Zqaq66/mspm0-temperature-recycling-robot/README.md

# MSPM0 移动测温回收机器人

基于 TI MSPM0G3507 的四轮移动机器人固件与载板设计资料。项目面向移动测温、房间巡检和物品回收任务，包含循迹导航、航向闭环、红外测温、语音提示、无线回传、LCD 显示及 PCB 载板设计。

## 主要功能

- 使用 AuroraT8 灰度传感器完成循迹、路口和支路识别。
- 基于路线表的任务状态机，支持房间停靠、回程、充电区和停车场流程。
- 使用 MLX90614 完成非接触体温测量，采用 PB17/PB18 软件 I2C。
- 使用 UART IMU 完成原地转向和航向闭环。
- 使用 ESP32-S2 授时模块获取日期和时间。
- 使用 ASRPRO2.0 播放房间与任务语音提示。
- 使用 LoRa 回传测量结果和设备状态。
- 使用 ST7735S LCD 显示任务状态、温度、电量及调试信息。
- 提供 MSPM0G3507 载板的 KiCad 原理图、立创 EDA 工程、BOM、网表和接线文档。

## 硬件组成

| 模块 | 用途 |
| --- | --- |
| 天猛星 MSPM0G3507 开发板 | 主控，LQFP-64，80 MHz |
| TB6612 x2 | 四路直流电机驱动 |
| AuroraT8 | I2C 灰度循迹 |
| MLX90614 | 红外测温 |
| UART IMU | 转向与航向反馈 |
| ESP32-S2 授时模块 | 日期和时间同步 |
| ASRPRO2.0 | 语音播报 |
| LoRa 模块 | 远程数据回传 |
| ST7735S LCD | 状态显示 |
| 12 V 电池组 | 电机与载板供电 |

详细引脚定义、电源树和上电检查流程见 [docs/PCB-接线汇总与注意事项.md](docs/PCB-接线汇总与注意事项.md) 与 [pcb/design_guide.md](pcb/design_guide.md)。上电前必须核对实物模块排针定义，尤其注意载板 3.3 V 与天猛星板载 3V3 不得直接并联。

## 目录结构

| 目录 | 内容 |
| --- | --- |
| `app/` | 电机、测温、语音和 IMU 驱动 |
| `middle/` | 任务状态机、循迹、通信、授时和调度 |
| `hardware/` | LCD 驱动与字库 |
| `grayscale/` | AuroraT8 灰度传感器驱动 |
| `BSP/` | 时间与板级支持 |
| `keil/` | Keil MDK 工程、启动文件和链接脚本 |
| `pcb/` | 载板 KiCad/立创 EDA 工程、BOM、网表和预览 |
| `docs/` | 接线与硬件注意事项 |
| `tools/` | PCB、原理图和框图生成脚本 |

## 构建

1. 安装 TI MSPM0 SDK 2.02.00.05 和 Keil MDK，并安装 MSPM0G350x 器件支持包。
2. 使用 Keil 打开 `keil/empty_LP_MSPM0G3507_nortos_keil.uvprojx`。
3. 选择与实物一致的下载器和调试配置，编译并下载固件。
4. 修改外设配置时使用 `empty.syscfg`，并确保生成的 `ti_msp_dl_config.c/.h` 与工程同步。

仓库不包含 Keil 编译产物和用户界面状态文件。`.gitattributes` 保留现有源码的编码与换行方式，避免无意义的整文件差异。

## 调试说明

- LoRa UART3 作为主要运行日志输出口。
- `middle/Mission.c` 中的 `route[]` 表定义任务路线和动作顺序。
- 循迹、转向、测温与语音模块均保留现场调试参数，调整前应先确认对应引脚和电源连接。
- 载板设计文件位于 `pcb/`；重新生成前请阅读生成脚本和验证报告。

## 状态

仓库持续记录机器人固件、任务流程和载板设计的开发进展。硬件行为仍需在实车、真实电源和对应模块上验证，不能仅以编译通过作为系统功能完成的依据。
