Zqaq66/mspm0-temperature-recycling-robot/pcb/netlist.txt

# DZZH carrier board logical netlist
# TMX.<pin> = 天猛星逻辑引脚; Jn.<pin> = 载板连接器

NET +3V3
  U1.OUT+
  C3.1
  C4.1
  R3.1
  R4.1
  R5.1
  R6.1
  R7.1
  R8.1
  J3.VCC
  J4.VCC
  J5.VCC
  J6.VCC
  J7.VCC
  J8.VCC
  J9.VCC
  J10.VIN
  J11.VCC
  J13.VCC
  J15.VCC
  J16.3V3
  J17.3V3

NET +3V3_T
  U3.OUT
  J14.3V3

NET +5V
  D2.A
  U2.OUT+
  U3.IN
  C5.1
  J12.5V

NET ENC_A_A
  J5.A
  TMX.PA21

NET ENC_A_B
  J5.B
  TMX.PA26

NET ENC_B_A
  J6.A
  TMX.PA31

NET ENC_B_B
  J6.B
  TMX.PA28

NET ENC_C_A
  J7.A
  TMX.PA24

NET ENC_C_B
  J7.B
  TMX.PA25

NET ENC_D_A
  J8.A
  TMX.PA14

NET ENC_D_B
  J8.B
  TMX.PA15

NET GND
  J1.2
  D1.G
  TVS1.2
  U1.IN-
  U1.OUT-
  U2.IN-
  U2.OUT-
  U3.GND
  C1.2
  C2.2
  C3.2
  C4.2
  C5.2
  C6.2
  R2.2
  LED1.K
  J3.GND
  J4.GND
  J5.GND
  J6.GND
  J7.GND
  J8.GND
  J9.GND
  J10.GND
  J11.GND
  J12.GND
  J13.GND
  J14.GND
  J15.GND
  SW1.2
  K1.2
  K2.2
  K3.2
  J16.GND
  J17.GND
  TMX.GND

NET I2C0_SCL
  R4.2
  J9.SCL
  TMX.PA1

NET I2C0_SDA
  R3.2
  J9.SDA
  TMX.PA0

NET I2C1_SCL
  R6.2
  J14.SCL
  TMX.PA29

NET I2C1_SDA
  R5.2
  J14.SDA
  TMX.PA30

NET IMU_RX
  J11.TX
  TMX.PA9

NET IMU_TX
  J11.RX
  TMX.PA8

NET KEY_K1
  K1.1
  TMX.PA16

NET KEY_K2
  K2.1
  TMX.PB1

NET KEY_K3
  K3.1
  TMX.PB23

NET KEY_S2
  SW1.1
  TMX.PB21

NET LCD_BLK
  J15.BLK
  TMX.PB26

NET LCD_CS
  J15.CS
  TMX.PB14

NET LCD_DC
  J15.DC
  TMX.PB11

NET LCD_MOSI
  J15.MOSI
  TMX.PB8

NET LCD_RES
  J15.RES
  TMX.PB10

NET LCD_SCLK
  J15.SCLK
  TMX.PB9

NET LED_A
  R8.2
  LED1.A

NET LORA_RX
  J13.TXD
  TMX.PB3

NET LORA_TX
  J13.RXD
  TMX.PB2

NET MA_OUT1
  J3.AO1

NET MA_OUT2
  J3.AO2

NET MB_OUT1
  J3.BO1

NET MB_OUT2
  J3.BO2

NET MC_OUT1
  J4.AO1

NET MC_OUT2
  J4.AO2

NET MD_OUT1
  J4.BO1

NET MD_OUT2
  J4.BO2

NET MLX_SCL
  J10.SCL
  TMX.PB17

NET MLX_SDA
  R7.2
  J10.SDA
  TMX.PB18

NET M_A_IN1
  J3.AIN1
  TMX.PB19

NET M_A_IN2
  J3.AIN2
  TMX.PB20

NET M_A_PWM
  J3.PWMA
  TMX.PA12

NET M_B_IN1
  J3.BIN1
  TMX.PB4

NET M_B_IN2
  J3.BIN2
  TMX.PB5

NET M_B_PWM
  J3.PWMB
  TMX.PA13

NET M_C_IN1
  J4.AIN1
  TMX.PB6

NET M_C_IN2
  J4.AIN2
  TMX.PB7

NET M_C_PWM
  J4.PWMA
  TMX.PA17

NET M_D_IN1
  J4.BIN1
  TMX.PB12

NET M_D_IN2
  J4.BIN2
  TMX.PB13

NET M_D_PWM
  J4.PWMB
  TMX.PA7

NET STBY
  J3.STBY
  J4.STBY
  TMX.PB0

NET SWCLK
  J16.SWCLK
  TMX.PA20

NET SWDIO
  J16.SWDIO
  TMX.PA19

NET TMX_5V
  D2.K
  TMX.5V

NET UART2_RX
  J17.RX
  TMX.PB16

NET UART2_TX
  J17.TX
  TMX.PB15

NET VBAT
  J1.1
  F1.1

NET VBAT_F
  F1.2
  D1.S

NET VBAT_SENSE
  C6.1
  R1.2
  R2.1
  TMX.PA27

NET VM_12V
  D1.D
  TVS1.1
  U1.IN+
  U2.IN+
  C1.1
  C2.1
  R1.1
  J3.VM
  J4.VM

NET VOICE_TX
  J12.RX
  TMX.PA10
