Zqaq66/mspm0-temperature-recycling-robot/pcb/carrier_block_diagram.png

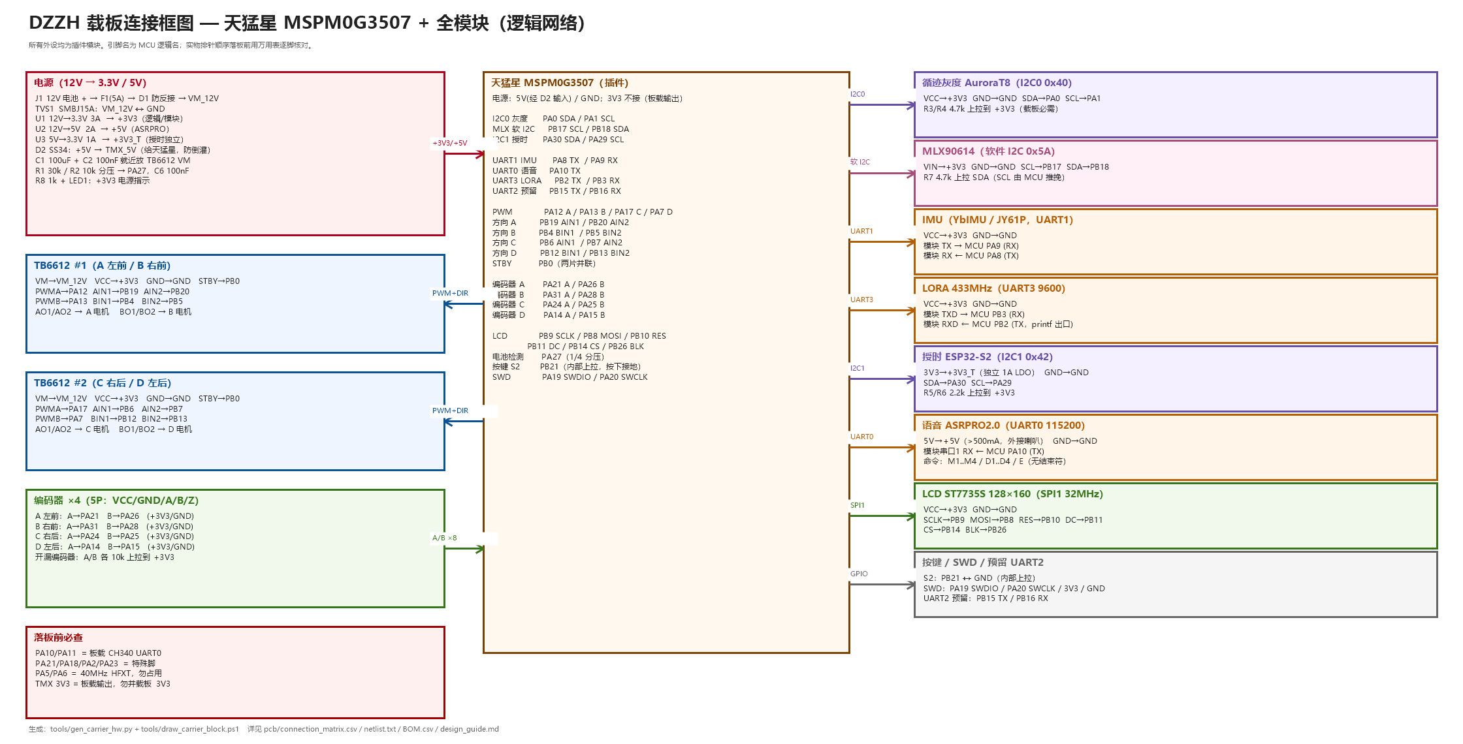
pcb/carrier_block_diagram.png
