Zqaq66/mspm0-temperature-recycling-robot/pcb/DZZH_carrier_sch_preview.png

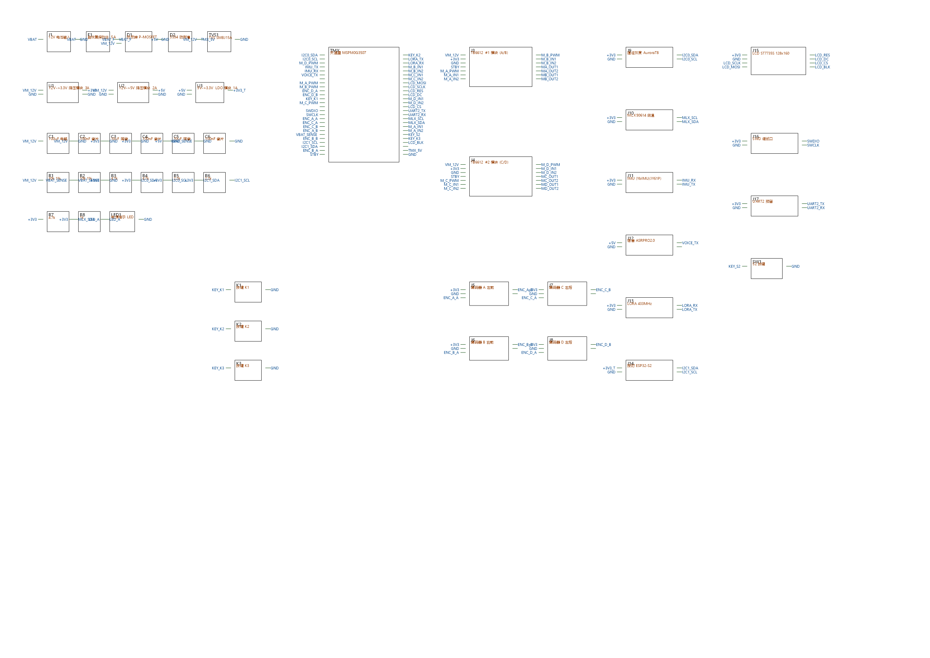
pcb/DZZH_carrier_sch_preview.png
