Zqaq66/mspm0-temperature-recycling-robot/pcb/BOM.csv

Qty | Item | Ref | Footprint | Note
1 | 天猛星 MSPM0G3507 开发板 | TMX | 插件（双排母，按实物） | 主控
2 | TB6612FNG 电机驱动模块 | J3,J4 | 2x8 2.54 + 端子 | A/B、C/D
1 | 芯流 AuroraT8 八路灰度 | J9 | 4P | I2C0 0x40
1 | MLX90614 测温模块 | J10 | 4P | 软 I2C PB17/PB18
1 | IMU 模块 (YbIMU/JY61P) | J11 | 4P | UART1
1 | LORA 433MHz 模块 | J13 | 4P | UART3 9600
1 | ESP32-S2 授时模块 | J14 | 4P | I2C1 0x42
1 | ASRPRO2.0 语音模块 + 喇叭 | J12 | 4P | UART0
1 | ST7735S 128x160 LCD | J15 | 8P | SPI1
4 | 编码器电机 / 编码器模块 | J5-J8 | 5P | A/B 相
1 | 12V->3.3V 降压模块 3A | U1 | 4P
1 | 12V->5V 降压模块 2A | U2 | 4P
1 | 5V->3.3V LDO 模块 1A | U3 | 3P | 授时独立供电
1 | 自恢复保险丝 5A | F1 | 1206/插件
1 | P-MOSFET AO3401 | D1 | SOT-23 | 防反接
1 | SS34 肖特基 | D2 | SMA | 天猛星 5V 防倒灌
1 | TVS SMBJ15A | TVS1 | SMB
1 | 100uF 电解 | C1 | 6.3x7.7
1 | 10uF 陶瓷 | C3 | 0805
1 | 10uF 陶瓷 | C5 | 0805
3 | 100nF 瓷片 | C2,C4,C6 | 0603
2 | 30k / 10k 1% | R1,R2 | 0603 | 1/4 分压
2 | 4.7k | R3,R4 | 0603 | I2C0 上拉
2 | 2.2k | R5,R6 | 0603 | I2C1 上拉
1 | 4.7k | R7 | 0603 | MLX SDA 上拉
1 | 1k | R8 | 0603 | LED 限流
1 | LED 3.3V 指示 | LED1 | 0603
1 | S2 轻触按键 | SW1 | 6x6
3 | 额外轻触按键 K1/K2/K3 | K1,K2,K3 | 6x6 | PA16/PB1/PB23，内部上拉
1 | 4P SWD 排针 | J16 | 2.54
1 | 4P 预留 UART2 | J17 | 2.54
