Zqaq66/mspm0-temperature-recycling-robot/pcb/BOM_lcsc.csv

Item | Ref | Qty | LCSC | MPN | Package | Note
10k 1% 0603 | R2 | 1 | C25804 | 0603WAF1002T5E | R0603 | 已验证
4.7k 1% 0603 | R3,R4,R7 | 3 | C23162 | 0603WAF4701T5E | R0603 | 已验证
1k 1% 0603 | R8 | 1 | C21190 | 0603WAF1001T5E | R0603 | 已验证
100nF 50V 0603 | C2,C4,C6 | 3 | C14663 | CC0603KRX7R9BB104 | C0603 | 已验证
10uF 25V 0805 | C3,C5 | 2 | C15850 | CL21A106KAYNNNE | C0805 | 已验证
红色 LED 0603 | LED1 | 1 | C2286 | KT-0603R | LED0603 | 已验证
SS34 SMA | D2 | 1 | C8678 | SS34 | SMA | 已验证
AO3401A SOT-23 | D1 | 1 | C15127 | AO3401A | SOT-23 | 已验证
2.54 1x3 排针 | U3 | 1 | C124376 | 210S-1*3P | HDR-TH_3P-P2.54-V-M | 已验证
2.54 1x4 排针 | U1,U2,J9,J10,J11,J12,J13,J14,J16,J17 | 10 | C124378 | Header-Male-2.54_1x4 | HDR-TH_4P-P2.54-V-M | 已验证
2.54 1x5 排针 | J5,J6,J7,J8 | 4 | C124379 | 210S-1*5P | HDR-TH_5P-P2.54-V-M | 已验证
2.54 1x8 排针 | J15 | 1 | C124381 | Header-Male-2.54_1x8 | HDR-TH_8P-P2.54-V-M | 已验证
2.54 2x8 排针 | J3,J4 | 2 | C124389 | 210S-2*8P | HDR-TH_16P-P2.54-V-M | 2x7 模块用 2x8 代（空 2 针）
2.54 2x20 排针 | TMX | 1 | C124383 | 210S-2*20P | HDR-TH_40P-P2.54-V-M-R2-C20 | 天猛星占位（按实物核对）
2.2k 1% 0603 | R5,R6 | 2 | C4190 | 0603WAF2201T5E | R0603 | 已验证
30k 1% 0603 | R1 | 1 | 待定 | 待定 | R0603 | 需按 30k 1% 选
SMBJ15A SMA | TVS1 | 1 | 待定 | 待定 | SMA | 需按 SMBJ15A 选
6x6 轻触按键 | SW1,K1,K2,K3 | 4 | 待定 | 待定 | SW-TH_6x6 | 需按 6x6x5 选
KF301-2P 端子 | J1 | 1 | 待定 | 待定 | KF301-2P | 需按 5.08mm 2P 选
100uF 35V 电解 | C1 | 1 | C72478 | RVT1V101M0607 | SMD-D6.3xL7.7 | 已验证
5A 自恢复保险丝 | F1 | 1 | 待定 | 待定 | Fuse1206 | 需按 1206 5A 选
