Zqaq66/mspm0-temperature-recycling-robot/pcb/validation_report.txt

DZZH carrier validation: 62 checks, 0 failure(s)

PASS  GPIO_I2C_0_SDA_PORT              expected GPIOA                got GPIOA
PASS  GPIO_I2C_0_SDA_PIN               expected DL_GPIO_PIN_0        got DL_GPIO_PIN_0
PASS  GPIO_I2C_0_SCL_PORT              expected GPIOA                got GPIOA
PASS  GPIO_I2C_0_SCL_PIN               expected DL_GPIO_PIN_1        got DL_GPIO_PIN_1
PASS  GPIO_I2C_TIME_SDA_PORT           expected GPIOA                got GPIOA
PASS  GPIO_I2C_TIME_SDA_PIN            expected DL_GPIO_PIN_30       got DL_GPIO_PIN_30
PASS  GPIO_I2C_TIME_SCL_PORT           expected GPIOA                got GPIOA
PASS  GPIO_I2C_TIME_SCL_PIN            expected DL_GPIO_PIN_29       got DL_GPIO_PIN_29
PASS  GPIO_UART_0_TX_PORT              expected GPIOA                got GPIOA
PASS  GPIO_UART_0_TX_PIN               expected DL_GPIO_PIN_10       got DL_GPIO_PIN_10
PASS  GPIO_IMU_TX_PORT                 expected GPIOA                got GPIOA
PASS  GPIO_IMU_TX_PIN                  expected DL_GPIO_PIN_8        got DL_GPIO_PIN_8
PASS  GPIO_IMU_RX_PORT                 expected GPIOA                got GPIOA
PASS  GPIO_IMU_RX_PIN                  expected DL_GPIO_PIN_9        got DL_GPIO_PIN_9
PASS  GPIO_LORA_TX_PORT                expected GPIOB                got GPIOB
PASS  GPIO_LORA_TX_PIN                 expected DL_GPIO_PIN_2        got DL_GPIO_PIN_2
PASS  GPIO_LORA_RX_PORT                expected GPIOB                got GPIOB
PASS  GPIO_LORA_RX_PIN                 expected DL_GPIO_PIN_3        got DL_GPIO_PIN_3
PASS  GPIO_Motor_PWM_Front_C0_PORT     expected GPIOA                got GPIOA
PASS  GPIO_Motor_PWM_Front_C0_PIN      expected DL_GPIO_PIN_12       got DL_GPIO_PIN_12
PASS  GPIO_Motor_PWM_Front_C1_PORT     expected GPIOA                got GPIOA
PASS  GPIO_Motor_PWM_Front_C1_PIN      expected DL_GPIO_PIN_13       got DL_GPIO_PIN_13
PASS  GPIO_Motor_PWM_Back_C0_PORT      expected GPIOA                got GPIOA
PASS  GPIO_Motor_PWM_Back_C0_PIN       expected DL_GPIO_PIN_17       got DL_GPIO_PIN_17
PASS  GPIO_Motor_PWM_Back_C1_PORT      expected GPIOA                got GPIOA
PASS  GPIO_Motor_PWM_Back_C1_PIN       expected DL_GPIO_PIN_7        got DL_GPIO_PIN_7
PASS  GPIO_ADC_VOLTAGE_C0_PORT         expected GPIOA                got GPIOA
PASS  GPIO_ADC_VOLTAGE_C0_PIN          expected DL_GPIO_PIN_27       got DL_GPIO_PIN_27
PASS  GPIO_LCD_DATA_PICO_PORT          expected GPIOB                got GPIOB
PASS  GPIO_LCD_DATA_PICO_PIN           expected DL_GPIO_PIN_8        got DL_GPIO_PIN_8
PASS  GPIO_LCD_DATA_SCLK_PORT          expected GPIOB                got GPIOB
PASS  GPIO_LCD_DATA_SCLK_PIN           expected DL_GPIO_PIN_9        got DL_GPIO_PIN_9
PASS  LCD_PORT                         expected GPIOB                got GPIOB
PASS  LCD_LCD_RES_PIN                  expected DL_GPIO_PIN_10       got DL_GPIO_PIN_10
PASS  LCD_LCD_DC_PIN                   expected DL_GPIO_PIN_11       got DL_GPIO_PIN_11
PASS  LCD_LCD_CS_PIN                   expected DL_GPIO_PIN_14       got DL_GPIO_PIN_14
PASS  LCD_BLK_PIN                      expected DL_GPIO_PIN_26       got DL_GPIO_PIN_26
PASS  Motor_PORT                       expected GPIOB                got GPIOB
PASS  Motor_AIN1_PIN                   expected DL_GPIO_PIN_19       got DL_GPIO_PIN_19
PASS  Motor_AIN2_PIN                   expected DL_GPIO_PIN_20       got DL_GPIO_PIN_20
PASS  Motor_BIN1_PIN                   expected DL_GPIO_PIN_4        got DL_GPIO_PIN_4
PASS  Motor_BIN2_PIN                   expected DL_GPIO_PIN_5        got DL_GPIO_PIN_5
PASS  Motor_CIN1_PIN                   expected DL_GPIO_PIN_6        got DL_GPIO_PIN_6
PASS  Motor_CIN2_PIN                   expected DL_GPIO_PIN_7        got DL_GPIO_PIN_7
PASS  Motor_DIN1_PIN                   expected DL_GPIO_PIN_12       got DL_GPIO_PIN_12
PASS  Motor_DIN2_PIN                   expected DL_GPIO_PIN_13       got DL_GPIO_PIN_13
PASS  Motor_STBY_PIN                   expected DL_GPIO_PIN_0        got DL_GPIO_PIN_0
PASS  ENCODER_PORT                     expected GPIOA                got GPIOA
PASS  ENCODER_E1A_PIN                  expected DL_GPIO_PIN_21       got DL_GPIO_PIN_21
PASS  ENCODER_E1B_PIN                  expected DL_GPIO_PIN_26       got DL_GPIO_PIN_26
PASS  ENCODER_E2A_PIN                  expected DL_GPIO_PIN_31       got DL_GPIO_PIN_31
PASS  ENCODER_E2B_PIN                  expected DL_GPIO_PIN_28       got DL_GPIO_PIN_28
PASS  ENCODER_E3A_PIN                  expected DL_GPIO_PIN_24       got DL_GPIO_PIN_24
PASS  ENCODER_E3B_PIN                  expected DL_GPIO_PIN_25       got DL_GPIO_PIN_25
PASS  ENCODER_E4A_PIN                  expected DL_GPIO_PIN_14       got DL_GPIO_PIN_14
PASS  ENCODER_E4B_PIN                  expected DL_GPIO_PIN_15       got DL_GPIO_PIN_15
PASS  KEY1_PORT                        expected GPIOB                got GPIOB
PASS  KEY1_UP_PIN                      expected DL_GPIO_PIN_21       got DL_GPIO_PIN_21
PASS  TW_PORT                          expected GPIOB                got GPIOB
PASS  TW_TW_0_PIN                      expected DL_GPIO_PIN_17       got DL_GPIO_PIN_17
PASS  TW_TW_1_PIN                      expected DL_GPIO_PIN_18       got DL_GPIO_PIN_18
PASS  MLX90614.c soft-I2C uses PB17/PB18
