Zqaq66/mspm0-temperature-recycling-robot/(list of files, drawings)

Other design files:
pcb/DZZH_carrier.epro
