Zqaq66/mspm0-temperature-recycling-robot/hardware/lcd.h

#ifndef __LCD_H
#define __LCD_H

#include "lcd_init.h"

/* Drawing */
void LCD_Fill(u16 xsta,u16 ysta,u16 xend,u16 yend,u16 color);
void LCD_DrawPoint(u16 x,u16 y,u16 color);
void LCD_DrawLine(u16 x1,u16 y1,u16 x2,u16 y2,u16 color);
void LCD_DrawRectangle(u16 x1, u16 y1, u16 x2, u16 y2,u16 color);
void Draw_Circle(u16 x0,u16 y0,u8 r,u16 color);

/* Text (ASCII only) */
void LCD_ShowChar(u16 x,u16 y,u8 num,u16 fc,u16 bc,u8 sizey,u8 mode);
void LCD_ShowString(u16 x,u16 y,const u8 *p,u16 fc,u16 bc,u8 sizey,u8 mode);
u32 mypow(u8 m,u8 n);
void LCD_ShowIntNum(u16 x,u16 y,u16 num,u8 len,u16 fc,u16 bc,u8 sizey);
void LCD_ShowHex(u16 x,u16 y,u32 num,u8 len,u16 fc,u16 bc,u8 sizey);
/* 显示定点数 (value_Q10 / 1024), 显示一位小数 */
void LCD_ShowFixedNum1(u16 x,u16 y,int32_t value_Q10,u8 len,u16 fc,u16 bc,u8 sizey);

void LCD_ShowPicture(u16 x,u16 y,u16 length,u16 width,const u8 pic[]);

/* 批量刷屏 + 文字层 (2026-10-06 新增, 非阻塞; 原理和时序见 lcd.c 顶部) */
#define LCD_ROWS   10                                 /* 屏高 160 / 字高 16 */
void LCD_ShowRowFast(u16 x,u16 y,const char *s,u16 fc,u16 bc);   /* 一行 4096B 一次推完 0.82ms */
void LCD_FillFast(u16 xsta,u16 ysta,u16 xend,u16 yend,u16 color);/* 整块填充, CS 只翻一次 */
void LCD_RowSet(u8 row, const char *txt, u16 fc);    /* 写文字影子: 只动 RAM, 立即返回 */
u8   LCD_RowFlush(void);                             /* 主循环里调: 1ms 最多推 1 行 */

/* Colors */
#define WHITE     0xFFFF
#define BLACK     0x0000
#define BLUE      0x001F
#define BRED      0XF81F
#define GRED      0XFFE0
#define GBLUE     0X07FF
#define RED       0xF800
#define MAGENTA   0xF81F
#define GREEN     0x07E0
#define CYAN      0x7FFF
#define YELLOW    0xFFE0
#define BROWN     0XBC40
#define BRRED     0XFC07
#define GRAY      0X8430
#define DARKBLUE  0X01CF
#define LIGHTBLUE 0X7D7C
#define GRAYBLUE  0X5458
#define LIGHTGREEN 0X841F
#define LGRAY     0XC618
#define LGRAYBLUE 0XA651
#define LBBLUE    0X2B12

#endif
