Zqaq66/mspm0-temperature-recycling-robot/app/HC05.h

/*
 * 立创开发板软硬件资料与相关扩展板软硬件资料官网全部开源
 * 开发板官网：www.lckfb.com
 * 文档网站：wiki.lckfb.com
 * 技术支持常驻论坛，任何技术问题欢迎随时交流学习
 * 嘉立创社区问答：https://www.jlc-bbs.com/lckfb
 * 关注bilibili账号：【立创开发板】，掌握我们的最新动态！
 * 不靠卖板赚钱，以培养中国工程师为己任
 */

#ifndef __BSP_HC05_H__
#define __BSP_HC05_H__

#include "ti_msp_dl_config.h"
#include "Time.h"
#include "string.h"

// 是否开启串口0调试     1开始  0关闭
#define  DEBUG   1

#define  BLERX_LEN_MAX  4

#define  BLUETOOTH_LINK      ((DL_GPIO_readPins( HCO5_PORT, HCO5_STATE_PIN ) & HCO5_STATE_PIN ) ? 1 : 0 )

#define  CONNECT             1       //蓝牙连接成功
#define  DISCONNECT          0       //蓝牙连接断开
extern unsigned char BLERX_BUFF[6];
extern unsigned char BL_flag;

void Bluetooth_Init(void);
unsigned char Get_Bluetooth_ConnectFlag(void);
void Bluetooth_Mode(void);
void Receive_Bluetooth_Data(void);
void BLE_send_String(unsigned char *str);
void BLE_Send_Bit(unsigned char ch);
#endif
