Zqaq66/mspm0-temperature-recycling-robot/(commit log)

2026-09-24 初始提交: MSPM0G3507 四轮小车工程 (DZZH_Project)
    驱动层
    LCD : ST7735S 128x160, 硬件 SPI1 (SCLK PB9 / MOSI PB8), RES/DC/CS/BLK = PB10/PB11/PB14/PB26
    电机 : TB6612 x 2, 四轮 A左前/B右前/C右后/D左后, PWM 20kHz, STBY = PB0
    编码器: 四路 AB 相, PA21/26, PA31/28, PA24/25, PA14/15, GPIO 中断 2 倍频
    灰度 : 芯流 AuroraT8 八路, 硬件 I2C0 (PA0/PA1, 0x40), 读 0x09 模拟量
    调度与配置
    middle/Task.c 协作式调度器 (5/10/20/100/1000ms), middle/Timer.c = TIMER_0 1ms 时基
    empty.syscfg 引脚/外设唯一来源 (SysConfig), ti_msp_dl_config.* 由它生成
    keil/*.uvprojx Keil MDK 工程 (AC6), 分散加载 mspm0g3507.sct
    应用 (em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
2026-10-04 IMU 原地转向 v6 (纯惯性滑行停) + 1ms 中断按键扫描 + LCD 统一行输出
    新增 middle/ImuTurn.c/.h (原地转到指定角度 / 保持航向):
    - 控制律: 远段定速(SPEED_MAX=170) -> 剩余<35度降到 MIN_PWM=120 低速接近
    -> 到提前刹车角(LEAD_DEG=10)切断驱动 -> 靠惯性滑到目标 -> 停稳判定落点
    -> 只有"停早了"才用最小 PWM 单向补足; 不做反向制动、不做回头修正
    - IMU_TURN_YAW_SIGN = -1: 实测 YbIMU 的 yaw 顺时针为正, 与驱动方向相反
    (这个符号搞反会导致"朝反方向全速转, 直到 norm180 变号才停" -> 停止角完全不对)
    - cur_yaw 归一化到 (-180,180]: 支持任意起点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
2026-10-04 IMU 原地转向 v7.1: 修假停稳bug + a打折 + 脉冲补一半 + 离线模拟器
    根因(按实测反推): a≈145°/s²(不是665), 最低可控转速切断就要滑44°, 是物理下限。
    1) 假停稳 bug(v6/v7 都有): 角速度原用 -d(|剩余角|)/dt, 冲过目标那一刻变号,
    低通值穿零 -> 误判停稳(车还在100度/秒以上转) —— 就是'停稳了但多转29度'。
    改为量 yaw 的带符号角速度 norm180(yaw-yaw_prev)*1000/dt。
    2) 切断判据只在 NEAR 低速段允许(否则一进 FAR 就满足 = 全速切断, 滑182度)。
    3) '该减速'用满速估计 RATE_FAST=250 算 -> 90/180 一开始就进低速段。
    4) 预测用 a 打折 DECEL_TRUST=0.70 (过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
2026-10-04 IMU 原地转 v7.2: 修 +-180 边界 (init_dir/diff 的 norm180 符号) + 模拟器保真度
    台架只测过 90 度(效果不错), 这次专门查 180 度, 发现一个必现的 bug:
    1) +-180 是 norm180 的边界 (它按约定返回 -180)。命令 +180 且从非零角度起步时
    target=norm180(cur+180) 会让 diff 落在 -180; 若 init_dir 取 delta 的符号(+1),
    '冲过目标'判据 ((diff<0)&&(init_dir>0)) 第一拍就为真 -> 250ms 后全速切断 ->
    滑 182 度。模拟: 修前落点误差 +120.4 度, 修后 +5.31 度。
    修法: 新增 _norm180_turn(d, sgn) 把边界值符号统一到命令方向; init_dir 改为按
    '几何上实际往哪边转' 定; Update 里 diff_de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
2026-10-04 台架配置: IMU_TURN_DEMO_DEG 90 -> 180 (验证 180 度原地转)
    只动一个宏, 不改任何逻辑; 转向控制律本身是 v7.2 (tag turn-v7.2)。
    编码已核对: 仍是纯 GBK + CRLF, 无 BOM。
    编译 23 个 .c / 0 error / LINK_EXIT=0。
2026-10-06 移动控制层(Mission) + I2C 授时查询端(TimeSync) + 清理无用模块
    【任务状态机: 循迹 -> 路口 -> 判向 -> 原地转 -> 恢复循迹】
    middle/Mission.c/.h (新): route[] 路线表 + 步骤状态机, 每步"动作+判据+步间停车",
    Mission_OnWork/Mission_OnStepEnter/Mission_OnDone 钩子供以后测温/语音/LCD/LORA
    middle/XunJi.c/.h: 新增路口检测(最左 bit0 / 最右 bit7 压线) + 房间检测(大面积压线),
    对外给电平(track_cross/track_room, 给屏看)和边沿式 TakeCross()/TakeRoom(), 另加 Track_Stop()
    empty.c: MISSION_ENABLE 开关(默认1), 5ms 槽由状态机接管, LCD 显示步号+速度
    【I2C 授时: ESP32-S2 模块作从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
2026-10-06 LCD 重排: 修重叠 (行 y 必须是 16 的倍数) + 工作模式只留 5 行, 调试行藏进 LCD_DEBUG
    问题:
    上一版把授时时间放在 y=144, 而 IMU 行在 y=136 —— 16 号字高 16px, 所以 y=136 那行
    实际占到 151, 和 y=144 叠了 8 个像素, 屏上两行糊在一起。
    改动 (只动 empty.c):
    - 引入行网格: LCD_Y(n) = n*16 (n=0..9) + R_STEP/R_PWM/R_TRACK/R_IMU/R_TIME 等行号常量,
    所有 lcd_row 一律走 LCD_Y(行号), 源码里不再出现裸数字 y —— 结构上杜绝再次叠行
    - LCD_imu()/LCD_clock() 改成带行号参数, 两个模式各自指定自己的行
    - 循迹模式 (工作用): 只显示 5 行
    第1行 状态 + 基速 (STOP pres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
2026-10-07 转弯/路口: 掉头退回直接原地转, 90度转弯走序列(前移+找线); 直角弯判据收紧; LCD 批量刷屏
    - Mission.c: MS_TURN 分两条路 (用户 2026-10-07 定, 别再混):
    |arg|>=180 掉头 : 直接 ImuTurn_TurnDeg(180,0) —— 不前移/不进转弯序列/不找线 (这版实测正常)
    MS_TURN_MEMO (出房间支线回上一个路口, 90): 盲走 MS_ADV_MS(250ms) -> 原地转 -> 传感器出口 -> 找线兜底
    修 bug: MS_TURN_MEMO(-2000) 也满足 |arg|>=180, 会把 -2000 当角度传给 ImuTurn (测试台抓到)
    转弯序列保护: 前移期 IMU 一直起不来 / 整段超时 -> 停车报警 fail=2 (屏 TURN fail)
    传感器出口门槛 = max(MS_TURN_SENSOR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
2026-10-08 XunJi: 岔路判据补"触发那侧 3 路必须已清空" (直角弯在岔路口前被误判成岔路)
    现象 (2026-10-07 用户实测): 岔路口前面加一个普通直角弯, 该直角弯仍被判成岔路。
    机理 (测试台复现, 见 track_test/corner_test.c [G][H]):
    直角弯在阵列上的帧很多时候是【外侧连续 3 路黑 + 总压线 3】并停好几帧
    (不是理想化的 5 路宽 ...#####)。窗口刚开的下一帧, 那 3 路展宽黑本身就和
    "中心掩码" bit2~5 重叠 (右触发含 bit5 / 左触发含 bit2) -> "中心有线"当场成立,
    总压线又是 3 <= BRANCH_LINE_MAX_BLACK -> 直接判岔路, 根本没等到"变全白"。
    修: 判据加一条 —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
2026-10-08 文档: Mission.c 表头加「怎么按场地填 route[] 表」+ 修 MS_TURN 过期注释
    - Mission.c: route[] 正上方新增 7 条填表说明
    0 表 = 车按顺序走过的每一段, 一行 = 一段路 + 一个退出条件
    2 每个动作(MS_TRACK/BLIND/TURN/WAIT/WORK/END)什么时候用
    3 六个退出条件(EX_ROOM/JUNC/CROSS/TIME/TURN/LINE)怎么选
    4 ★三种拐弯分别怎么写: 普通弯不写表 / 岔路口 MS_CROSS(arg 只说转不转) /
    180 掉头 MS_TURN +180 (不前移) / 支线回主路 MS_TURN MEMO (前移 250ms)
    5 一个房间 = 连着的 5 行 + 为什么顺序不能乱 (房间口和 T 字口判据相同, 靠位置区分)
    6 stop_ms (本行做完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
2026-10-08 路线表: 按用户口述的完整路线重填 (31 行: 4 个房间 + 回程 + 充电区 + 停车场)
    route[] 按 2026-10-07 用户口述重写 (左右以小车视角为准):
    J1/J2 出发: 两个岔路口直行穿过 (MS_CROSS arg=0)
    T1 WORK1 + U180 + BACK1 + M90_1 1 号房间: 停车做事 -> 掉头 -> 回主路
    J3 T2 WORK2 + U180 + BACK2 + M90_2 2 号房间: 岔路口拐弯进
    J4 T3 WORK3 + U180 + BACK3 + M90_3 3 号房间: 岔路口拐弯进
    T4 WORK4 + U180 4 号房间: 普通弯(右拐)进; 出门也是普通弯 -> 不写 MEMO 行
    J5/J6 回程两个岔路口直行穿过; L90 = T 字路口左拐 (-90, 走转弯序列: 前移250+转+找线)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
2026-10-08 整表模式: MISSION_DEBUG_STEPS 7 -> 0 (31 行一路跑完: 4 个房间 + 回程 + 充电区 + 停车场)
    - 源码默认改成 0 = 跑整张表; 注释保留分段验的对照 (7/13/19/23/26/28)
    - 也可以不动源码, Keil Misc Controls 加 -DMISSION_DEBUG_STEPS=N 临时覆盖
    验证: route[] 整表测试 (不加 -D, 走源码默认) 全过 —— 31 行走到 END,
    12 次转向角度+步号全对, 4 个房间钩子收到 room 1-4, 无找线摆动,
    看不到线 -> NOLINE / IMU 起不来 -> fail=2 / 卡住 -> 15s 看门狗
    armclang: 22 个 .c 0 error 0 warning, RO 36124 (与上版一致)
2026-10-13 功能: Mission_OnWork 房间环节 (测温/电量/屏显结果区/LORA回传/语音)
    - empty.c: WORK_FEATURES 开关 + 电量ADC(PA27) + MLX90614测温 + 屏第6~10行结果区
    + Mission_OnWork/OnDone 实现 + TW_Init/UART_Init
    - middle/LORA.c: 修 LOAR_USART_Send_Bit/send_String 硬编码 UART1 -> LORA_INST
    - app/MLX90614.h: 修误导注释, 补用法
    构建: 0 error / 0 warning, Code=34912 RO-data=3588 RW-data=188 ZI-data=6236
2026-10-13 整理: 删除测试脚手架与死代码, 精简注释
    删除 (只用于台架测试 / 无人调用):
    - app/HC05.c/.h 蓝牙, 与本题目无关
    - app/Encoder.c/.h 编码器只在电机测试模式用 (循迹/转向不用)
    - middle/PID.c/.h 速度环只在电机测试模式用
    - empty.c: APP_MODE 两套固件 -> 只留循迹; IMU 演示; 开环自检步表; LCD_status
    - XunJi: Track_Err (旧实现) ; UART: UART_send_string/UART_send_Data/uart_timeout_cnt
    - Motor: Motor_PWM_Front/Back (无人调用), Motor_Disable, Turn_left/right
    优化:
    - Motor.c: 四路方向控制抽成 dir_out() 一个 helper, 去掉三份重复 (237 -> 64 行)
    - XunJi.h: 拍平嵌套的 #ifndef; 修 "P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
2026-10-13 整理: LORA.h 清掉 STM32 教程残留宏
    - 删掉照抄 STM32 例程的 RCC_LORA_xx / PORT_LORA_xx / GPIO_LORA_xx
    (会误导接线; 真实引脚 TX=PB2 / RX=PB3 由 SysConfig 的 LORA_INST 决定)
    - 教程 banner 换成简洁说明; 数组尺寸统一用 LOAR_RX_LEN_MAX
    构建: 0 error / 0 warning, Code=32456 RO-data=2884 RW-data=156 ZI-data=6100
2026-10-13 XunJi: 在线自适应双参考阈值 + 滞回 + 3 帧中值 (治污渍/光照漂移的假房间/假转弯)
    问题: 阈值 = "上电标一次白底 + 固定 ADAPT_MARGIN", 全程锁死。
    污渍变暗、光照漂移(黑线反差缩小)都会让 v > white+margin 在直道上假成立 ->
    nb 冲高判成房间, 或中心几路判白 -> 命中"普通弯"窗口。
    改法 (XunJi.c 阈值层, 全部可 -D 覆盖, 全关 = 退回旧行为):
    - ADAPT_ONLINE: white[i]/black[i] 两个慢速 IIR 跟踪值, 压线阈值取二者之间
    (自适应反差); black 从"细线帧"的判黑路学, white 从判白路学
    - HYST_ENABLE: 滞回双阈值 (>= hi 压线 / <= lo 放开, 中间保持), 消阈值附近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
2026-10-13 修复: 滞回判定把压线位写反, 导致巡线完全失效
    hb 初值 0xFF (bit=1 表示白), 却写成 `if (!black) hb |= (1u<<i);` ——
    对一个本来就是 1 的位再置 1 等于空操作, 于是每一路恒读成"白":
    bits 恒为 0xFF -> nb=0 -> den=0 -> 每帧都走丢线分支, 车不巡线。
    (旁证: 编译器据此证明 hb 恒为常量, 把整条判定/PD 都当死代码消掉了 ——
    所以那一版 Code 反而只有 31984, 修好后回到 33992。)
    改为 `if (black) hb &= ~(1u<<i);` (判黑就清那一位)。
    构建: 0 error / 0 warning, Code=33992 RO-data=2880 RW-data=156 ZI-data=6052
2026-10-13 XunJi: 自适应初值改成"进入门槛 = 旧固定阈值", 避免开机就看不见线
    原 black 初值 = white + 2*margin, 进入门槛 = white + 0.6*2*margin = white+72,
    比旧的固定阈值 white+margin(=60) 高 12 个计数。反差不够大的线一开机就判不出来 ->
    学不到黑参考 -> 自适应永远起不来, 比改之前还容易丢线。
    改成 m = 5*margin/3 -> 进入门槛 = white + margin, 与旧行为完全一致;
    释放门槛 = white + 0.4*m (更宽容) 提供滞回。初值宁低勿高。
    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
2026-10-13 导航重构: 传感器只报原始事件, 语义全交给路线表
    问题: 传感器分不开"丁字口横杠 / 停车线 / 房间黑块"(都是 nb>=6), 也分不清
    "岔路 vs 普通弯"(定帧数窗口)。于是直线上的污渍/光照漂移会演化成假房间/假转弯,
    J1 还会被"普通弯自动转"抢走。方向靠传感器判也不可靠 (正撞丁字口左右两支一样)。
    改法:
    - XunJi: 只报两种原始事件 —— EV_BLACK (nb>=6 且最长连续压线>=5, 连续 4 帧) /
    EV_CORNER (外侧连续 3 路压线 + 中心全白, 连续 5 帧)。
    删掉整块岔路/普通弯窗口 (BRANCH_* / REARM_* / CROSS_EDGE_BLACK_REQ)
    + Track_TakeBranch / track_branch。EV_BLACK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
2026-10-13 修复: 普通弯(EV_CORNER)判定条件自相矛盾, 永远不触发 -> 左上角不转弯
    上一版把"外侧连续 3 路压线"和"中心那几路全白"写成【同一拍】必须同时成立:
    外侧连续 3 路 (右) = bit5~7 压线 -> 要求 bit5 黑
    中心 mask 0x3C = bit2~5 全白 -> 要求 bit5 白
    两者矛盾, 所以 EV_CORNER 一帧都发不出来: 车到普通直角弯只会照直开, 然后丢线停下。
    (老代码能工作是因为它把这两件事分在不同帧: 先开窗, 窗口到期再看中心 —— 我"简化"时
    把时间维度删掉了。)
    改回"先开窗、再数帧", 并加一个兜底触发:
    ① 外侧连续 CORNER_EDGE_BLACK_REQ 路压线 -> 开窗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
2026-10-13 普通弯改成表里单独一行 (MS_CORNER, 方向写死); 循迹段不再自动转
    现象: 回传日志显示转弯发生在 MSTEP 0 (J1 充电区丁字口) —— 按表那一步应该直行穿过,
    却触发了 d-90 左转; 而左上角该右转的地方方向也判反了。
    原因:
    - MS_CROSS / MS_TRACK 的循迹段里还在响应"普通弯"事件 -> 在丁字口自己拐了 90 度
    (这也解释了为什么"表说了算"没做彻底)。
    - 转弯方向取自传感器的侧向判定 -> 实测在口子上不可靠 (判反了)。
    - 新增动作 MS_CORNER: 循迹到"线拐走了" -> 前移 + 按表中 arg 转 90 + 找线兜底。
    - ms_do_track() 只做 Track_Run(), 不再处理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
2026-10-13 补第三种事件 EV_BRANCH: "沿主线走、支线在侧面"的丁字口 (大面积黑抓不到)
    现象: 出 1 号房间回主路那一步 (R1, MS_CROSS 左拐) 不转弯, 直接直走。
    原因: 那个口是【沿着主线走、支线垂直于行进方向】—— 支线只压住阵列【端部】1 路左右,
    主线还占着中心那几路, 阵列拼不出 nb>=6 -> EV_BLACK 永远不触发 -> 步骤卡住直走。
    (这类口和"正面撞上横杠"的口是两种几何; 老代码的"岔路"检测就是干这个的,
    我重构时误删了。)
    - 新增 EV_BRANCH = 最左或最右压线 且 中心(bit3/bit4)还有线 且 不是大面积黑, 连续 3 帧
    -> Track_TakeBranch(); 与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
2026-10-13 掉头(MS_TURN 180)补诊断输出: T180 r<原因> e<剩余角> y<航向>
    现象: 2 号房间 U180 只打了 TGO(起转), 下一步紧接着就开始了 —— 车没真的掉头。
    180 度掉头这条路走的是 ImuTurn_TurnDeg (不走转弯序列), 所以除 TGO 外一行日志都没有,
    完全看不出是 "IMU 掉线 / 超时 / 被顶住" 哪一种。
    查过 ImuTurn: ±180 边界的 diff 已按命令方向修正 (不会第一拍误判"冲过目标"),
    ERRWAY 也只在驱动段判 (切断后不看) —— 所以只能靠运行时的原因码定位。
    改动: 掉头结束(或中止)时打一行 T180 r<0到位/1被停/2IMU掉线/3超时/4被顶住> e.. y..,
    非 0 时置 ms_fail=2 ->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
2026-10-14 修复: 大角度掉头只转几度就报"到位" (has_crossed 被一帧 yaw 毛刺翻起)
    现象 (2026-10-13 两次上板):
    T180 r0 e+3 ← 1号/2号掉头正常
    T180 r0 e+176 ← 掉头"报告到位", 实际只转了 4 度, 车根本没掉头
    两次分别死在 3 号房间 / 2 号房间 -> 间歇性, 与当拍 yaw 数据有关。
    机理: "冲过目标" has_crossed 是【不可逆】锁存位 —— 一帧 yaw 毛刺把 diff 的符号翻过来就
    置 1, 于是立刻切断驱动 (只转了几度), 紧接着"到位/不该再补"分支看到 has_crossed 就
    _finish(ARRIVED) -> 谎报到位, 状态机带着没转完的车往下走。
    改法 (ImuTurn):
    - has_crossed 增加"必须已转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
2026-10-14 掉头改成"两次 90 度": 180 度一次转会踩 ±180 边界, 过半程被误判"越走越远"
    现象 (2026-10-13 连续两次上板): 1 号房间掉头只转一半就停:
    TGO +180 a-1 -> T180 r4 e-81 / e-85 (r4 = ERRWAY, 还剩约 83 度)
    根因: ImuTurn 的"剩余角"是按【归一化差】算的 (_norm180_turn(target-cur))。
    转 180 度时这个差值在起点就是 ±180 边界; 一旦【转过半程】, "从当前位置到目标"的
    最短路径方向就翻到另一边 -> 剩余角符号翻转 -> 被 ERRWAY 判据 ("驱动段一直在远离目标")
    认定"方向反了/被顶住" -> 立刻停车收工。这是 180 度这个角度本身的歧义, 不是调参能治的。
    改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
2026-10-28 功能: 完成移动测温回收流程并加入载板设计
2026-10-28 文档: 约定仓库持续更新流程
